antabianshahan/orange-fresh-eis/figures/fig01_session1_bode.png

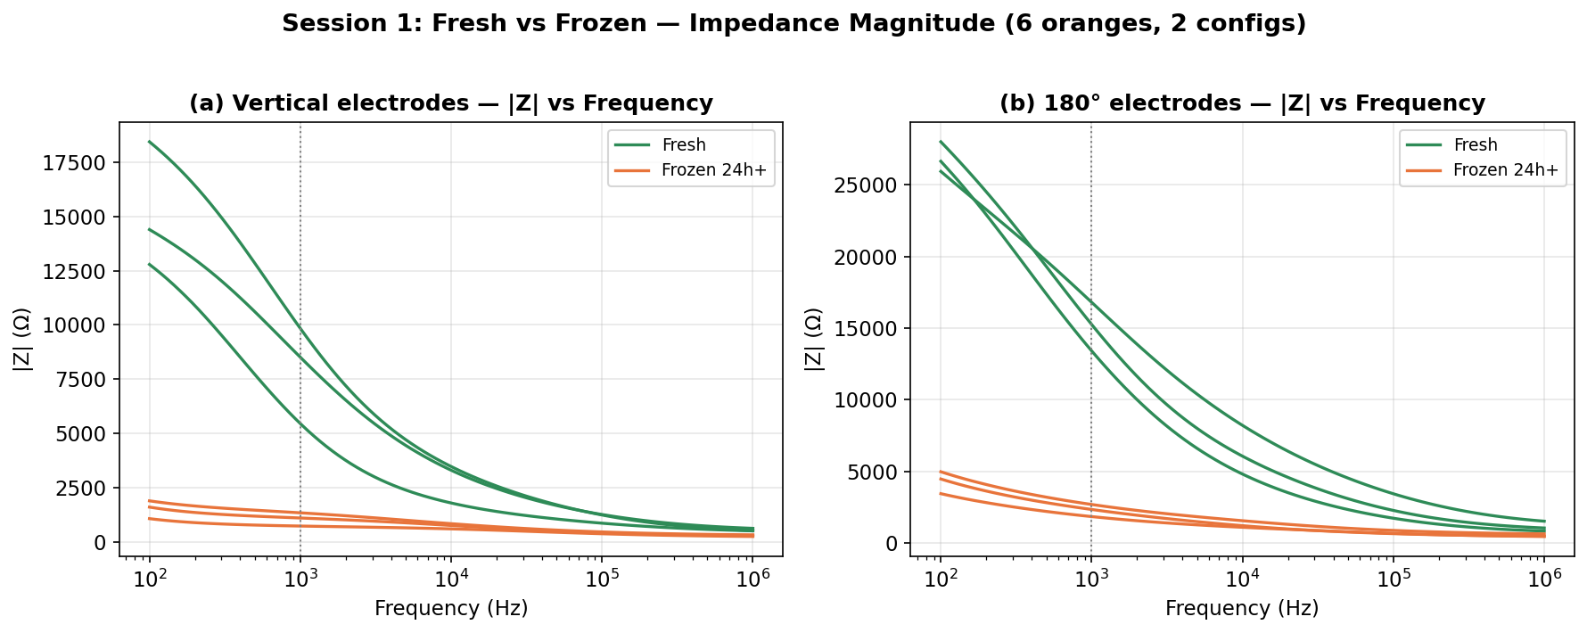
figures/fig01_session1_bode.png
