antabianshahan/orange-fresh-eis/figures/fig04_session2_freezecurve.png

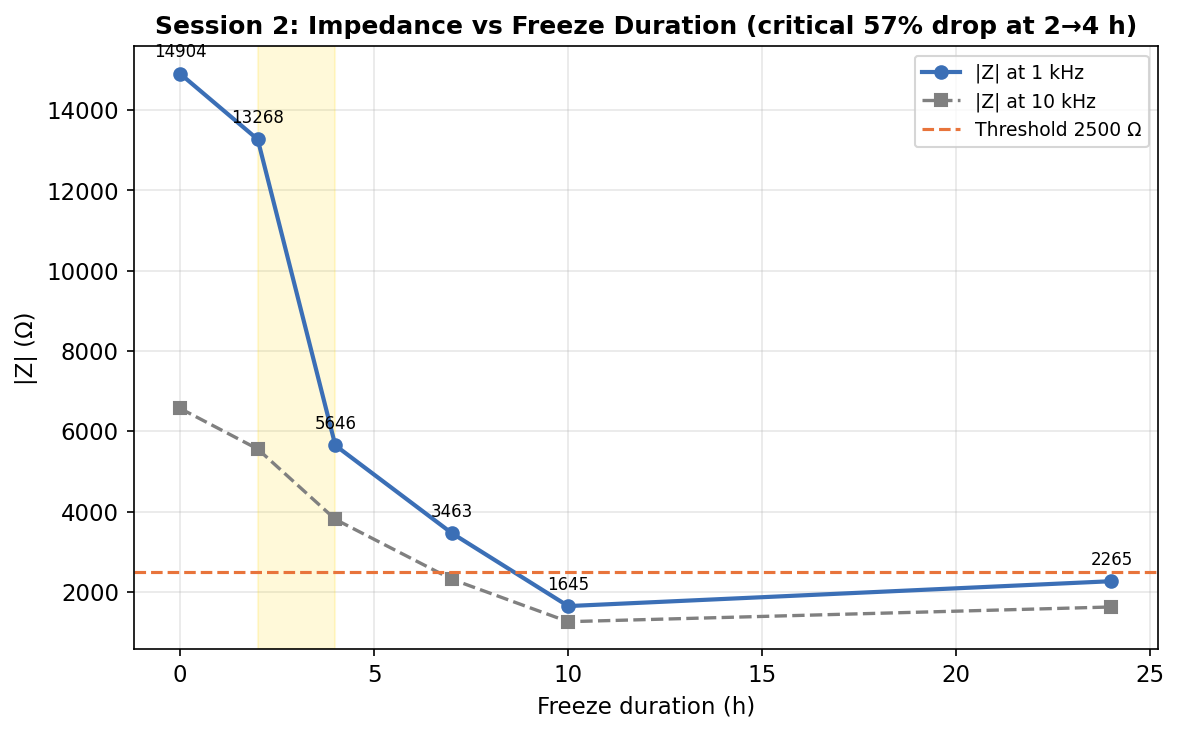
figures/fig04_session2_freezecurve.png
