antabianshahan/orange-fresh-eis/figures/fig05_session2_multifreq.png

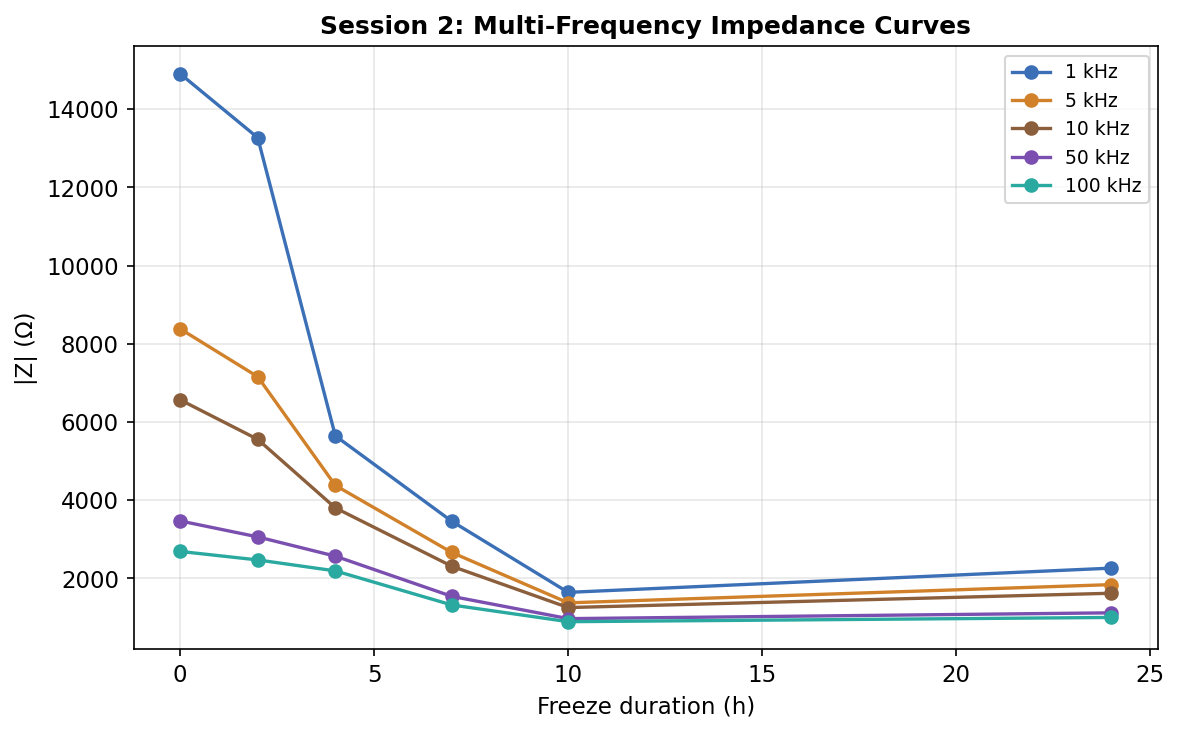
figures/fig05_session2_multifreq.png
