antabianshahan/orange-fresh-eis/figures/fig06_session2_nyquist.png

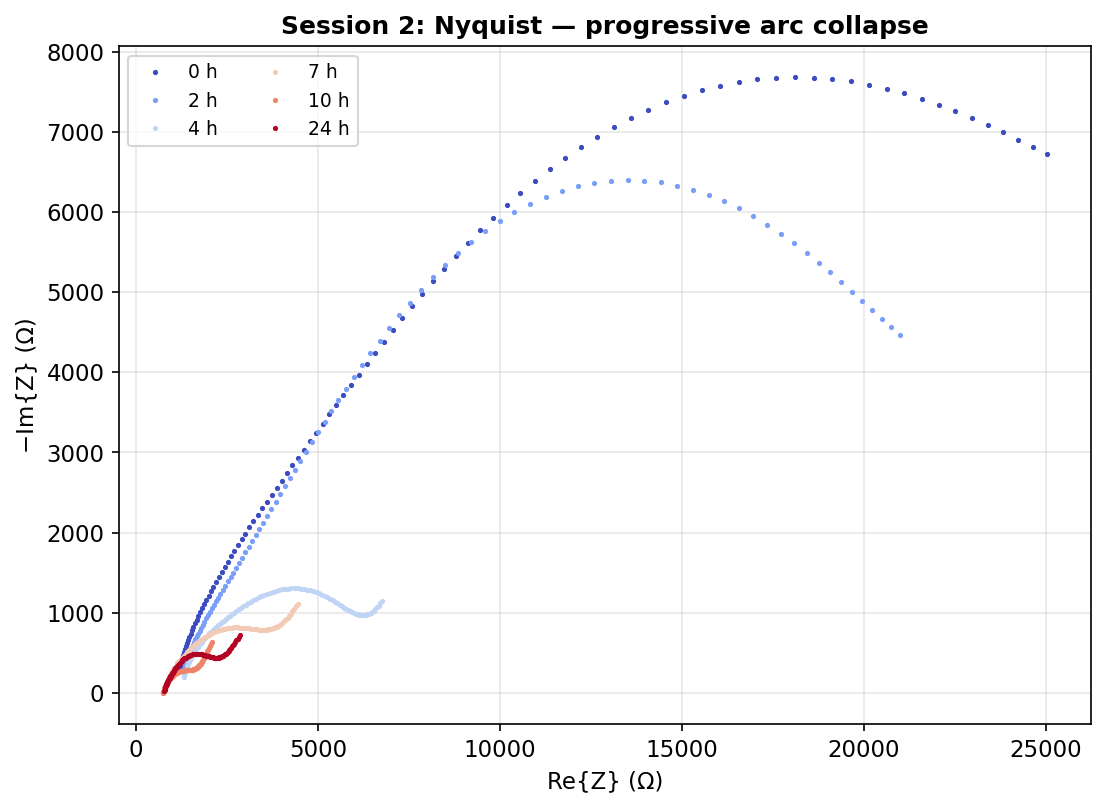
figures/fig06_session2_nyquist.png
