antabianshahan/orange-fresh-eis/figures/fig07_session2_phase.png

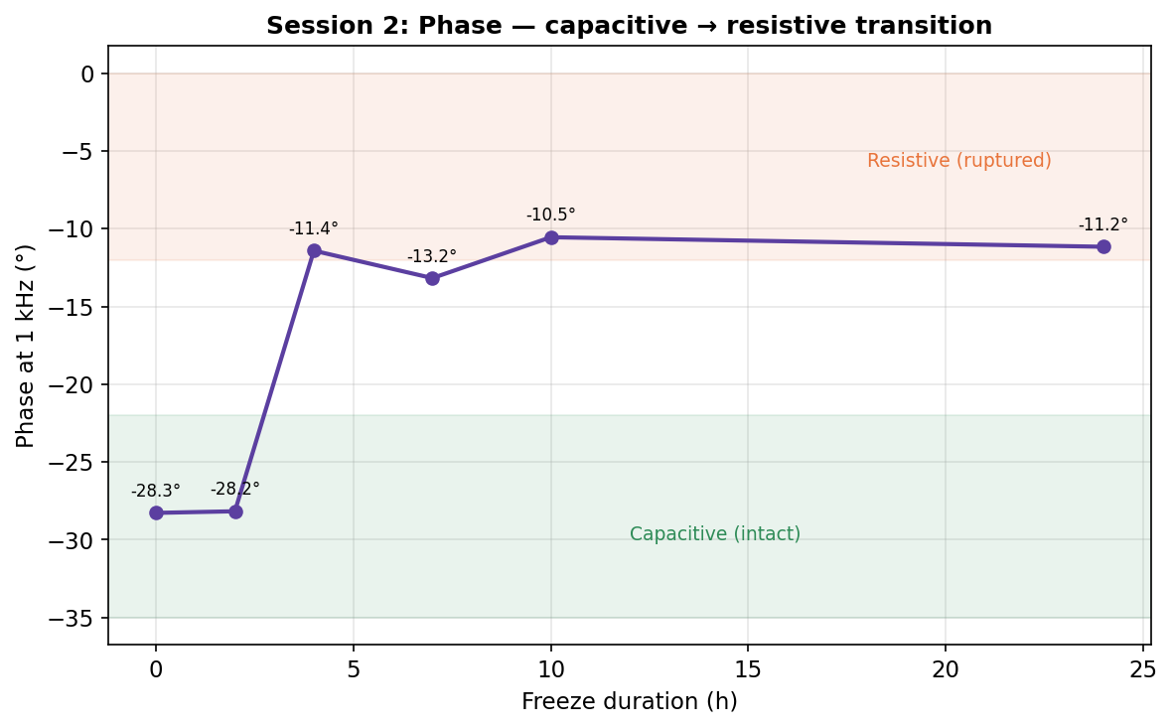
figures/fig07_session2_phase.png
