antabianshahan/orange-fresh-eis/figures/fig09_session3_diameter.png

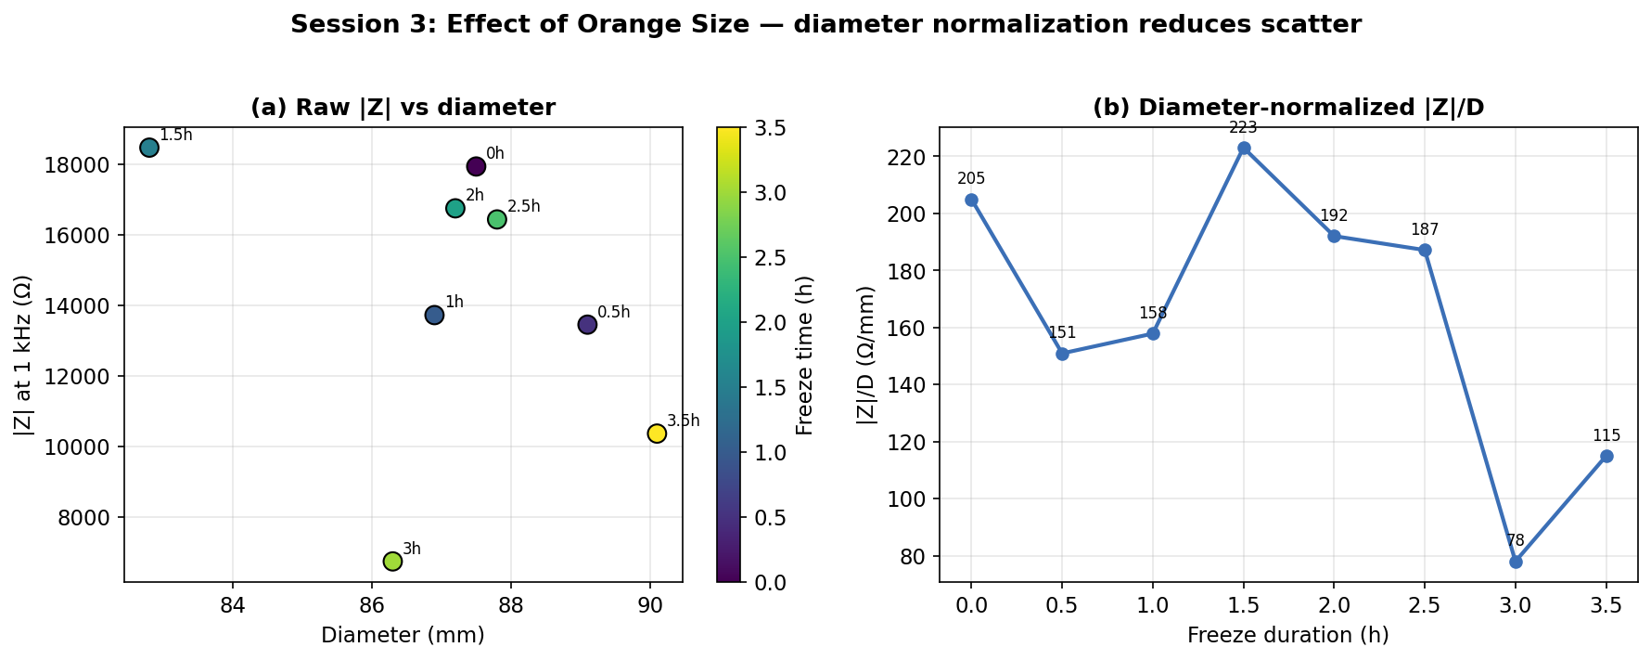
figures/fig09_session3_diameter.png
