antabianshahan/orange-fresh-eis/figures/fig11_feature_space.png

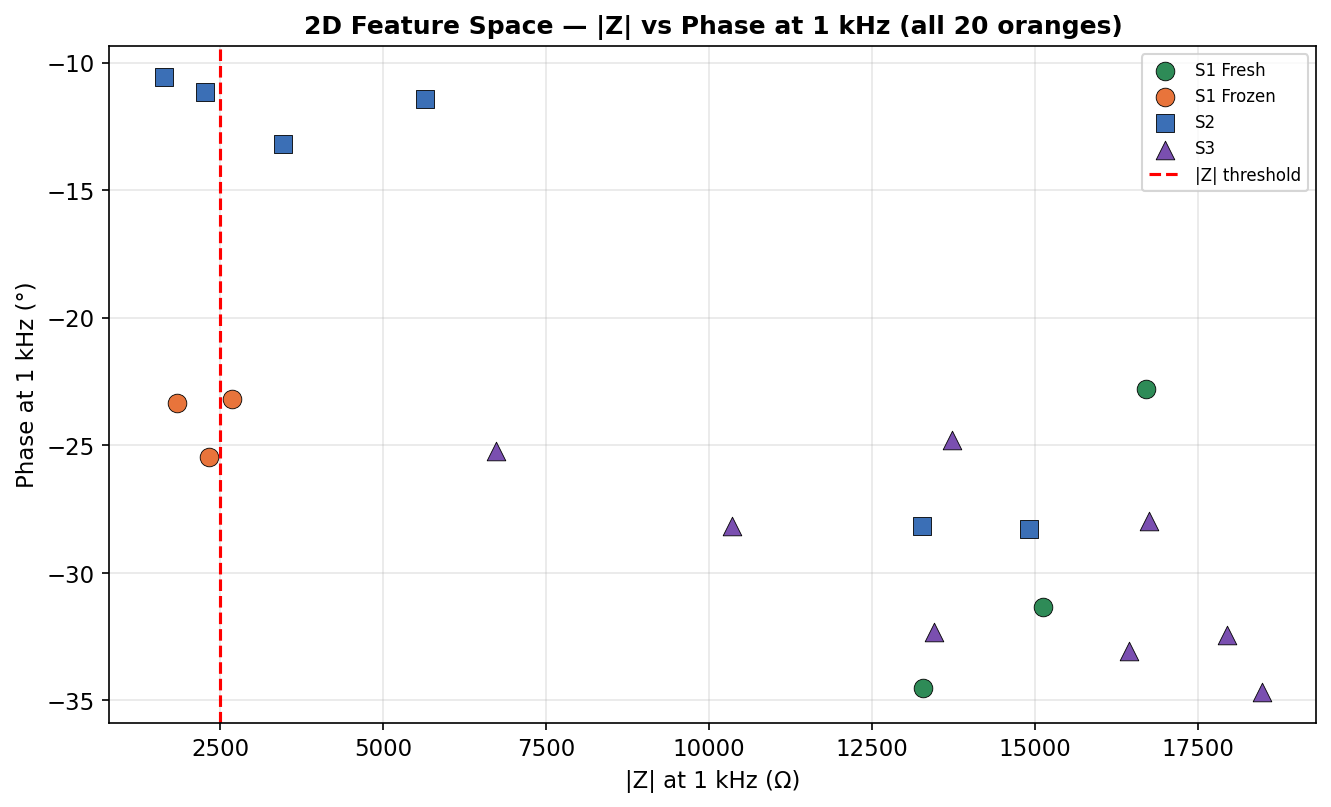
figures/fig11_feature_space.png
