antabianshahan/orange-fresh-eis/figures/fig12_classification_1d.png

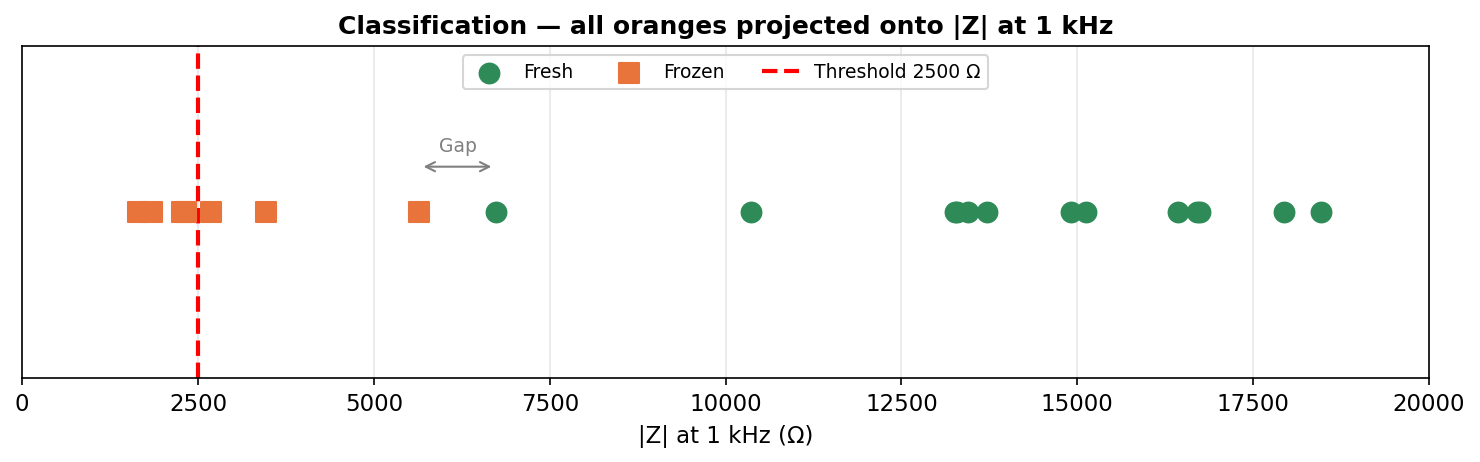
figures/fig12_classification_1d.png
