antabianshahan/orange-fresh-eis/figures/fig13_classification_stats.png

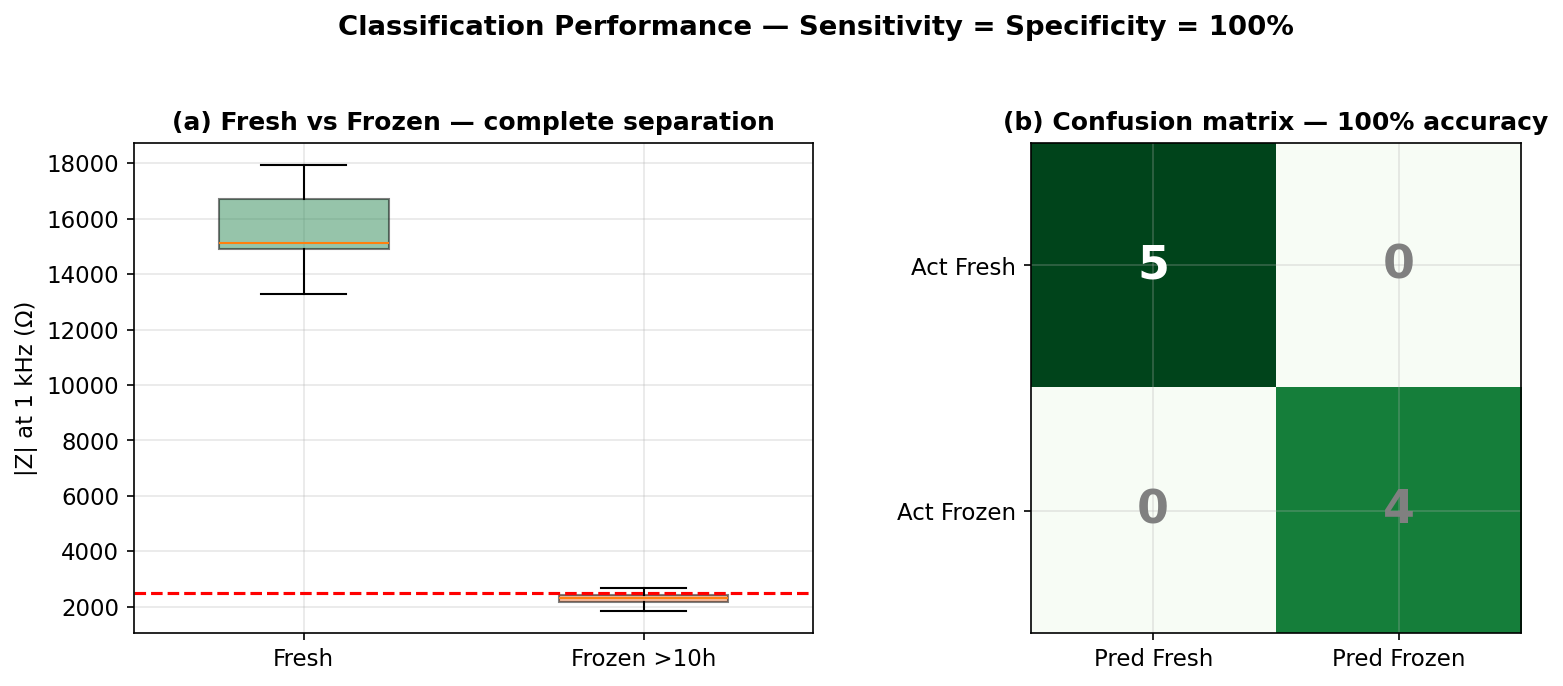
figures/fig13_classification_stats.png
