antabianshahan/orange-fresh-eis/hardware/orange_support.stl

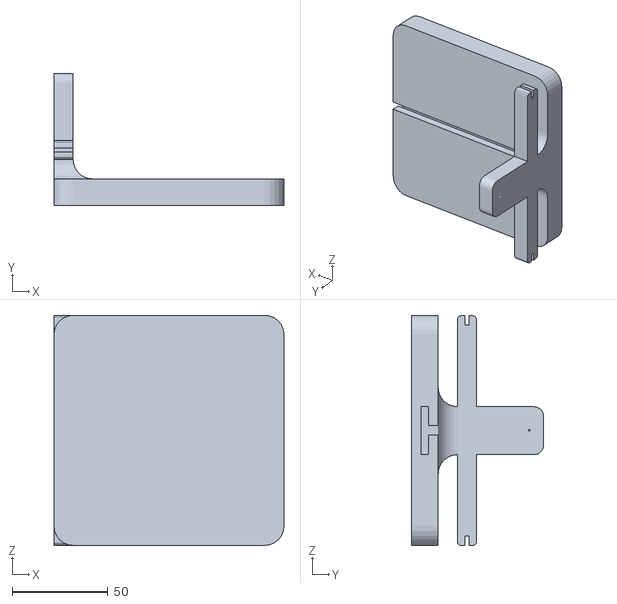
[picture p59: CAD file, 2026-11-09]
hardware/orange_support.stl
120.0 x 69.0 x 120.2
