antabianshahan/orange-fresh-eis/hardware/mobile_support.stl

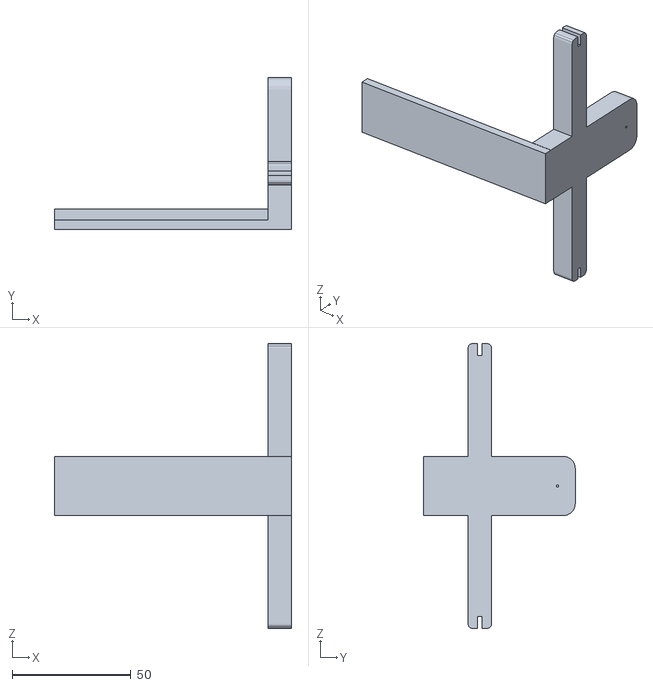
[picture p60: CAD file, 2026-11-09]
hardware/mobile_support.stl
99.8 x 63.8 x 120.0
