antabianshahan/orange-fresh-eis/(commit log)

2026-11-09 Restructure as a project portfolio
    - Move the HTML presentation from README.md to index.html (GitHub Pages)
    - Add README with results and figures
    - Add MATLAB analysis, AD5933 firmware, 3D-printed holders, final report
    Claude-Session: https://claude.ai/code/session_01M3rnPWhtp33GbSvuq6V7Ga
    [mobile_support.stl, orange_support.stl]
2026-11-09 README: label the web presentation as the proposal-stage deck
    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
